cjsatuforc/ScannerRobo/README.md

# Project ScannerLaser

Developing a small laser scanner with a single CMD camera and two lasers. 
One of these lasers is coupled with a small DC motor and the controller of the motor is being implemented in a small arduino nano pro board.

Everything communicating with a PC via USB serial
