cjsatuforc/ScannerRobo/caixa_scanner_otimizada/Caixa_Scanner.SLDASM

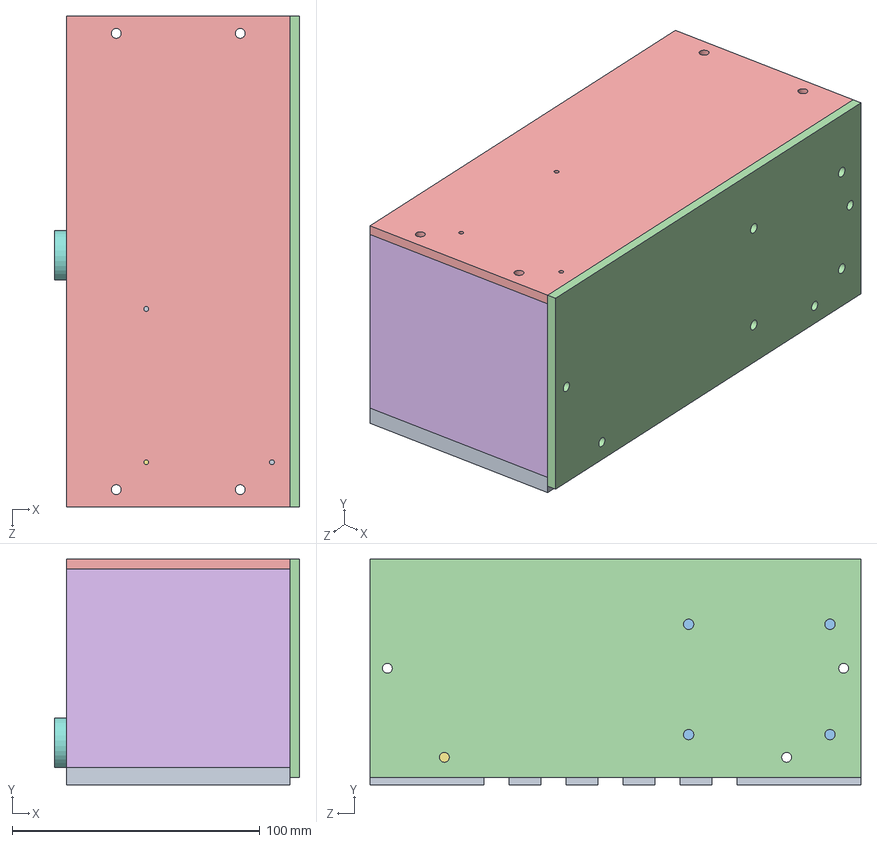
[picture p1: CAD file, 2016-11-16]
caixa_scanner_otimizada/Caixa_Scanner.SLDASM
99.0 x 91.0 x 198.0 mm
Lateral_Fixacao
Placa
Camera
Tampa_Superior
Tampa_Frontal
Tampa_Lateral x 2
Laser_Motor
Laser_Fixo
Bracadeira_Laser
