cjsatuforc/ScannerRobo/caixa_scanner_otimizada/Tampa_Lateral_furada.SLDPRT

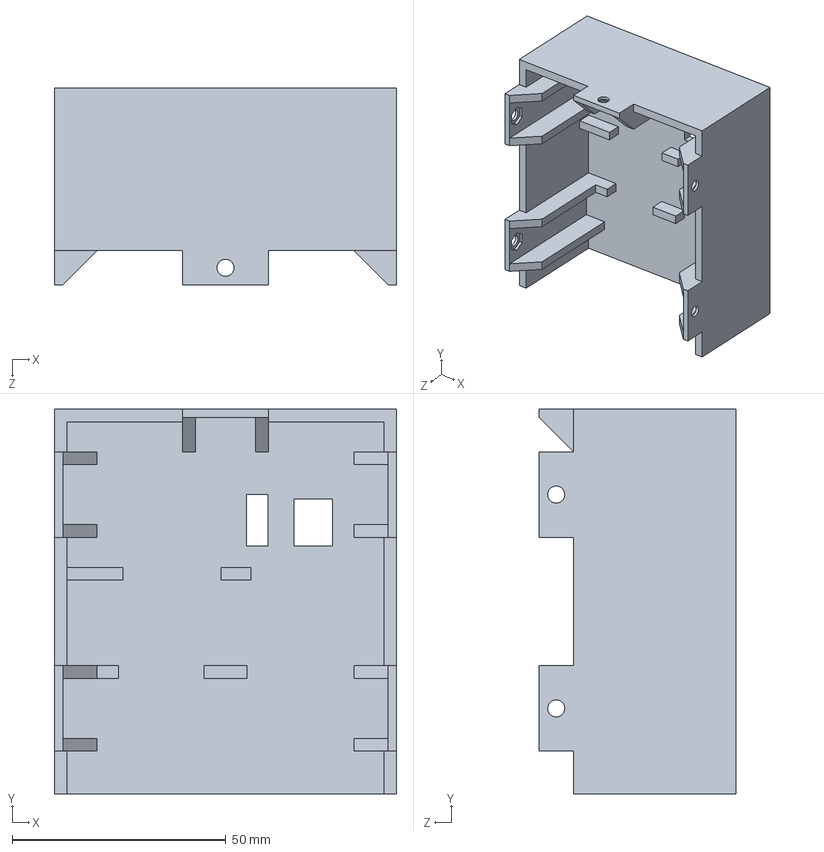
[picture p2: CAD file, 2016-12-11]
caixa_scanner_otimizada/Tampa_Lateral_furada.SLDPRT
80.0 x 90.0 x 46.0 mm
