cjsatuforc/ScannerRobo/caixa_scanner_otimizada/Laser_Motor.SLDPRT

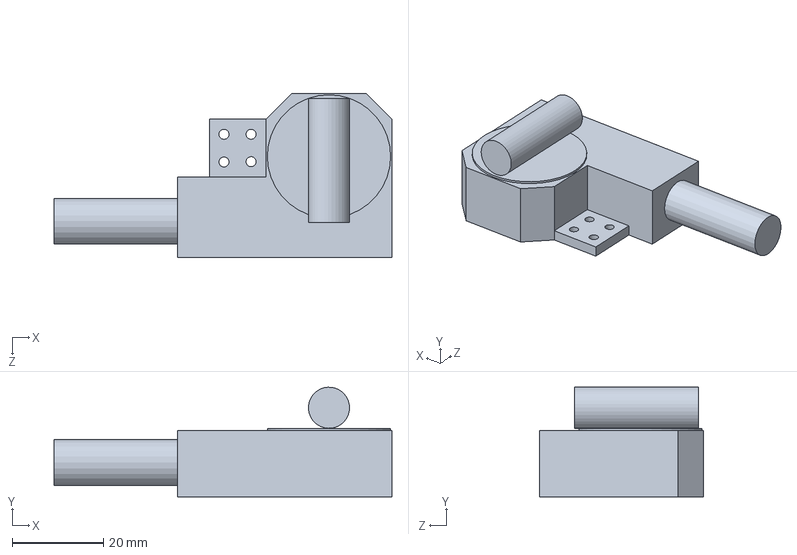
[picture p3: CAD file, 2016-11-16]
caixa_scanner_otimizada/Laser_Motor.SLDPRT
74.0 x 24.0 x 36.0 mm
