cjsatuforc/ScannerRobo/caixa_scanner_otimizada/Tampa_Lateral.SLDPRT

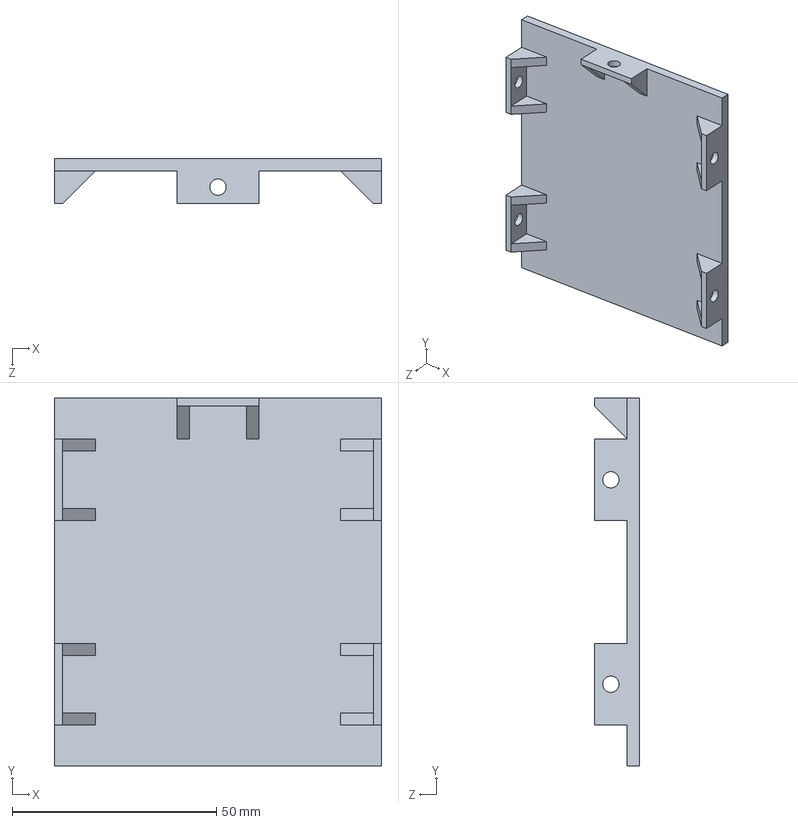
[picture p4: CAD file, 2016-11-16]
caixa_scanner_otimizada/Tampa_Lateral.SLDPRT
80.0 x 90.0 x 11.0 mm
