cjsatuforc/ScannerRobo/caixa_scanner_otimizada/Tampa_Frontal.SLDPRT

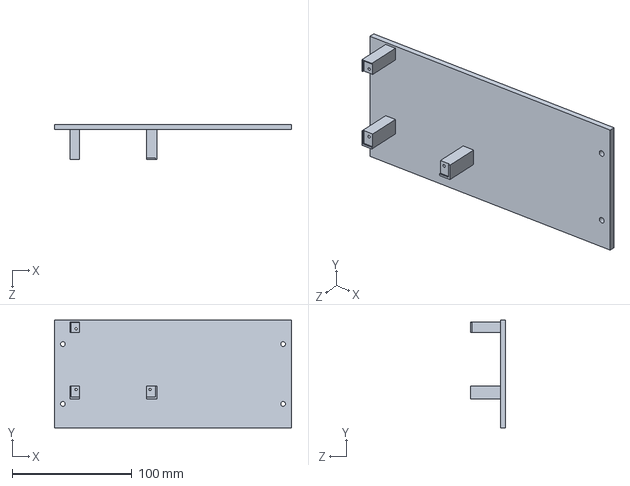
[picture p5: CAD file, 2016-11-16]
caixa_scanner_otimizada/Tampa_Frontal.SLDPRT
198.0 x 90.0 x 29.0 mm
