cjsatuforc/ScannerRobo/caixa_scanner_otimizada/Placa.SLDPRT

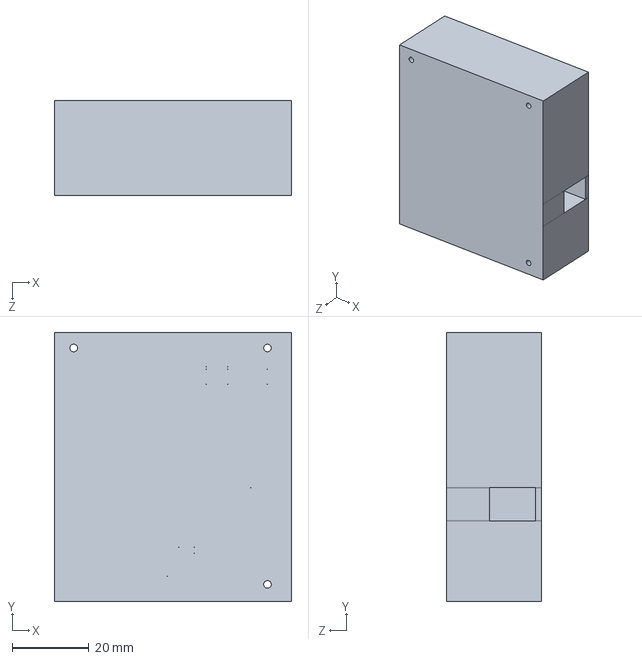
[picture p6: CAD file, 2016-11-16]
caixa_scanner_otimizada/Placa.SLDPRT
62.0 x 70.3 x 25.0 mm
