cjsatuforc/ScannerRobo/caixa_scanner_otimizada/Camera.SLDPRT

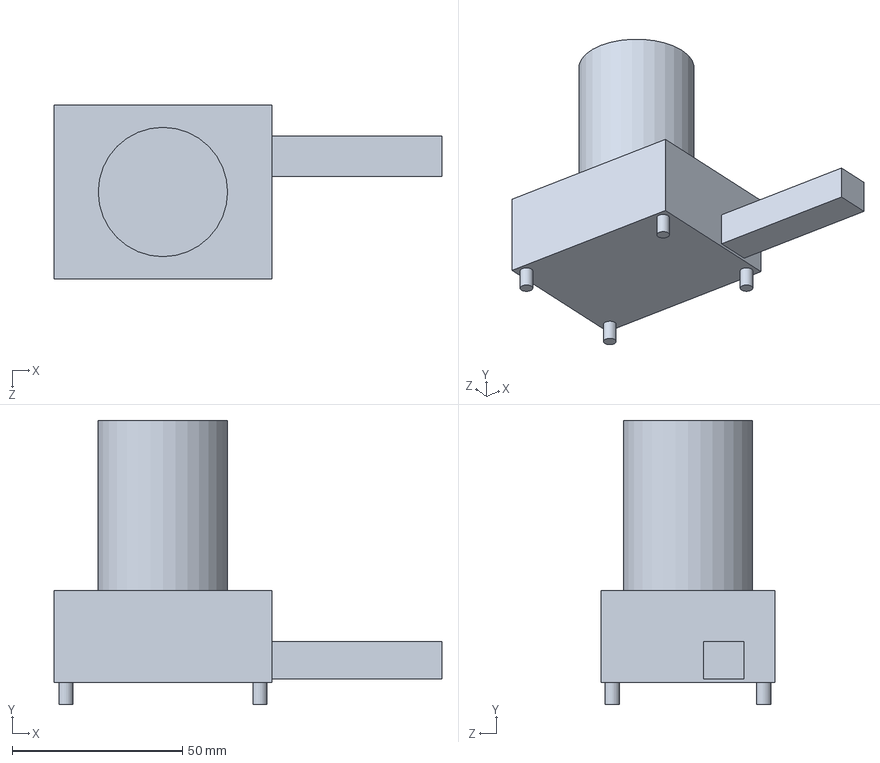
[picture p7: CAD file, 2016-11-16]
caixa_scanner_otimizada/Camera.SLDPRT
114.0 x 83.5 x 51.0 mm
