cjsatuforc/ScannerRobo/caixa_scanner_otimizada/Superficie1.SLDPRT

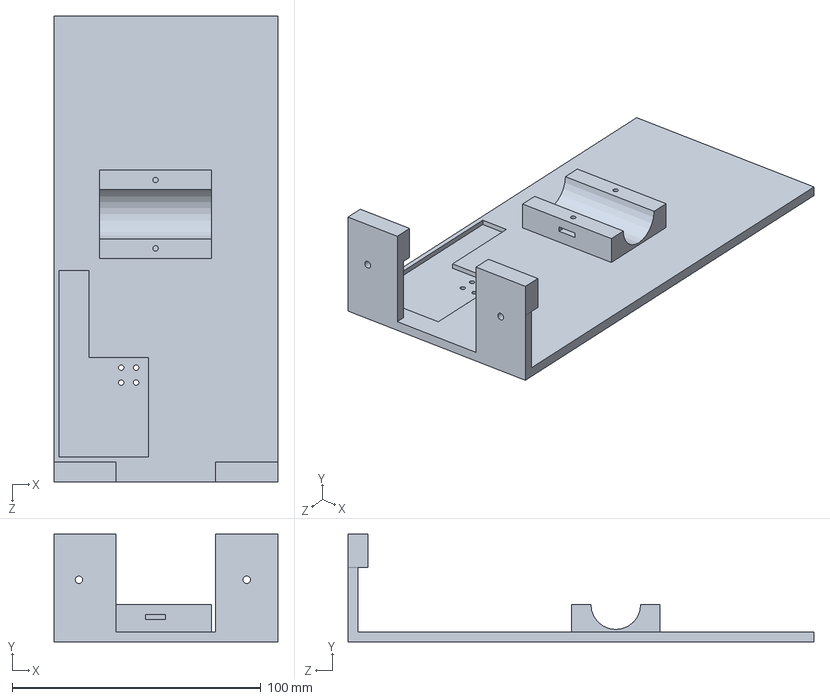
[picture p8: CAD file, 2016-11-16]
caixa_scanner_otimizada/Superficie1.SLDPRT
90.1 x 43.4 x 187.5 mm
