cjsatuforc/ScannerRobo/caixa_scanner_otimizada/Lateral_Fixacao.SLDPRT

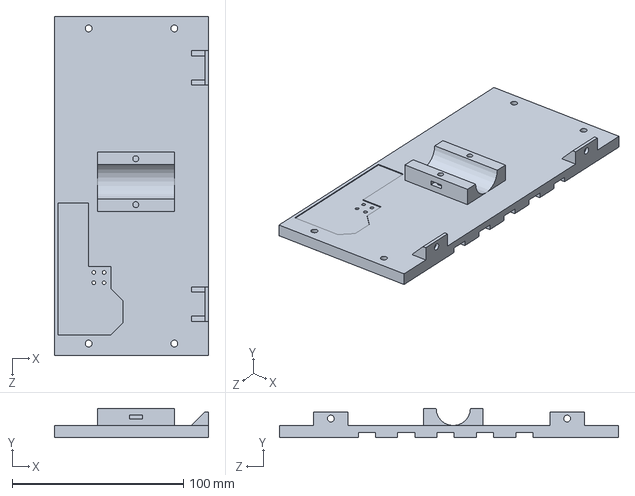
[picture p9: CAD file, 2016-11-16]
caixa_scanner_otimizada/Lateral_Fixacao.SLDPRT
90.0 x 17.0 x 198.0 mm
