cjsatuforc/ScannerRobo/caixa_scanner_otimizada/Laser_Fixo.SLDPRT

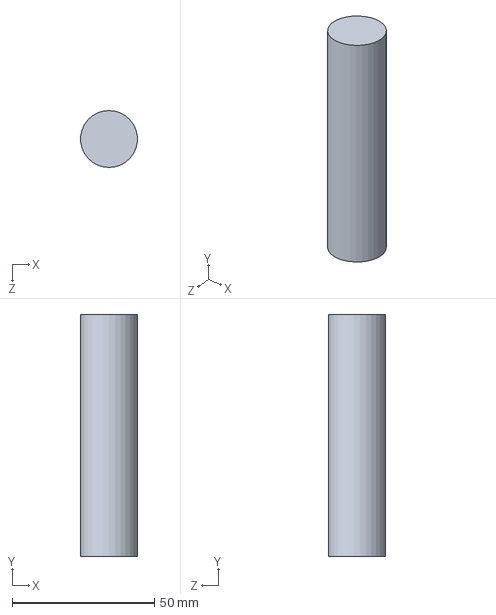
[picture p10: CAD file, 2016-11-16]
caixa_scanner_otimizada/Laser_Fixo.SLDPRT
19.9 x 85.0 x 20.0 mm
