cjsatuforc/ScannerRobo/caixa_scanner_otimizada/Bracadeira_Laser.SLDPRT

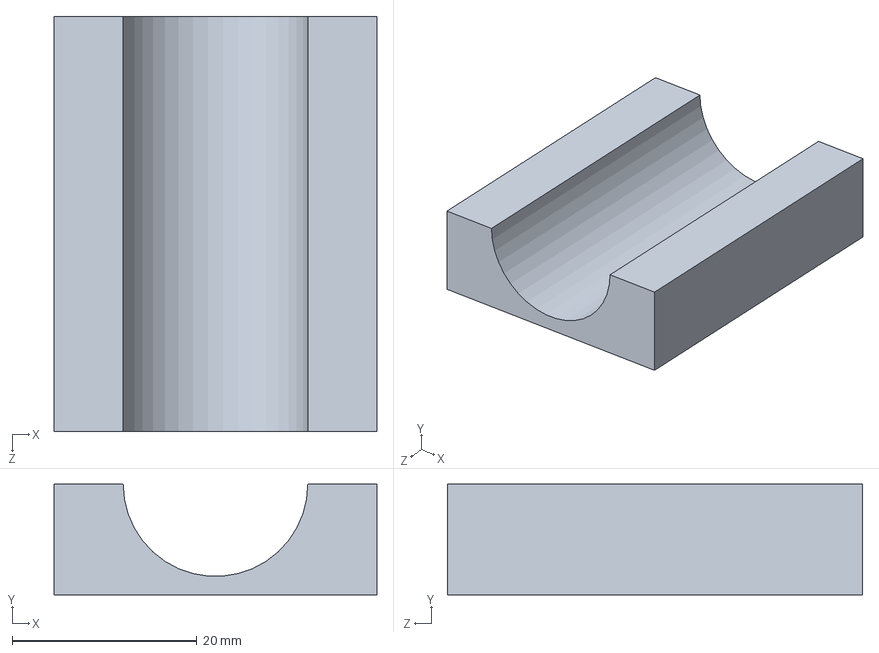
[picture p11: CAD file, 2016-11-16]
caixa_scanner_otimizada/Bracadeira_Laser.SLDPRT
35.0 x 12.0 x 45.0 mm
