cjsatuforc/ScannerRobo/caixa_scanner_otimizada/Tampa_Superior.SLDPRT

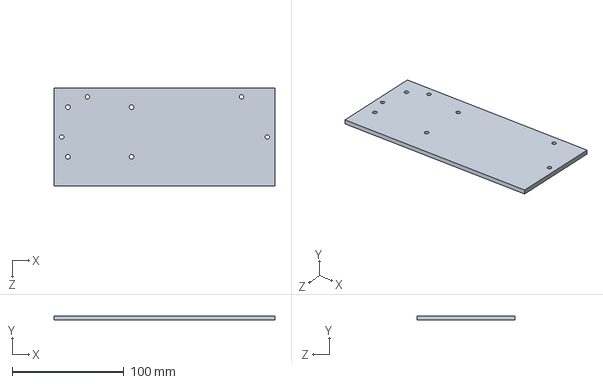
[picture p12: CAD file, 2016-11-16]
caixa_scanner_otimizada/Tampa_Superior.SLDPRT
198.0 x 4.00 x 88.0 mm
