cjsatuforc/ScannerRobo/(list of files, cad)

Other CAD files:
caixa_scanner_otimizada/Lateral_Fixacao.STL
caixa_scanner_otimizada/Tampa_Frontal.STL
caixa_scanner_otimizada/Tampa_Lateral.STL
caixa_scanner_otimizada/Tampa_Lateral_furada.STL
caixa_scanner_otimizada/Tampa_Superior.STL
