cjsatuforc/ScannerRobo/PCBdev/Arduino Micro - Scanner/micro_board.pdf

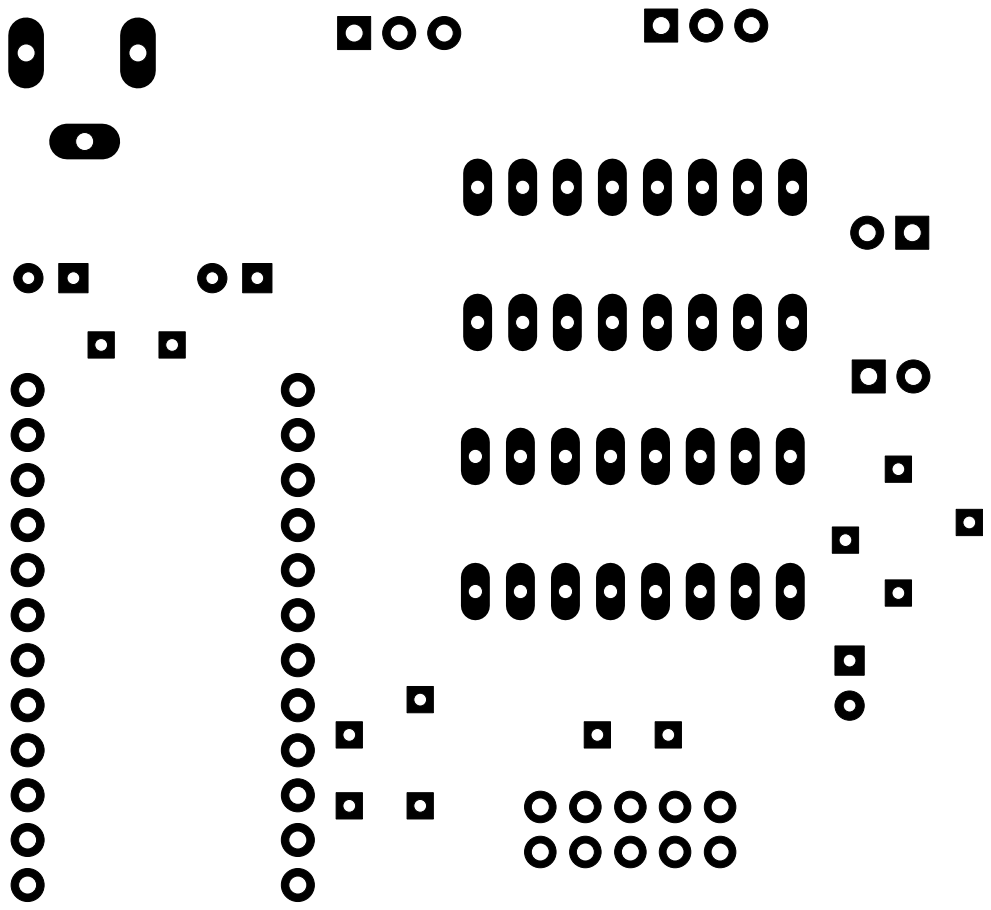
[picture p13: page 1]
