cjsatuforc/ScannerRobo/PCBdev/Arduino Nano - Scanner/nano_board.pdf

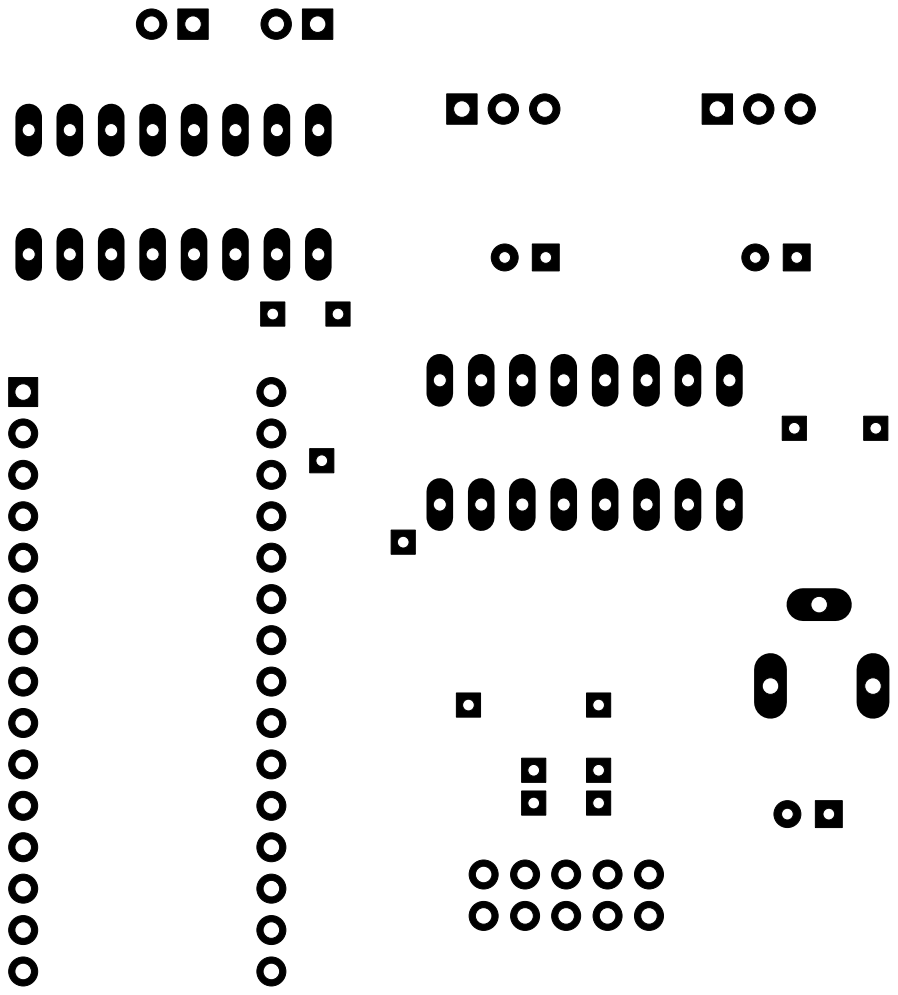
[picture p14: page 1]
