cjsatuforc/ScannerRobo/PCBdev/Arduino Nano - Scanner/micro_board.brd

## EAGLE design PCBdev/Arduino Nano - Scanner/micro_board.brd (2016-11-04)

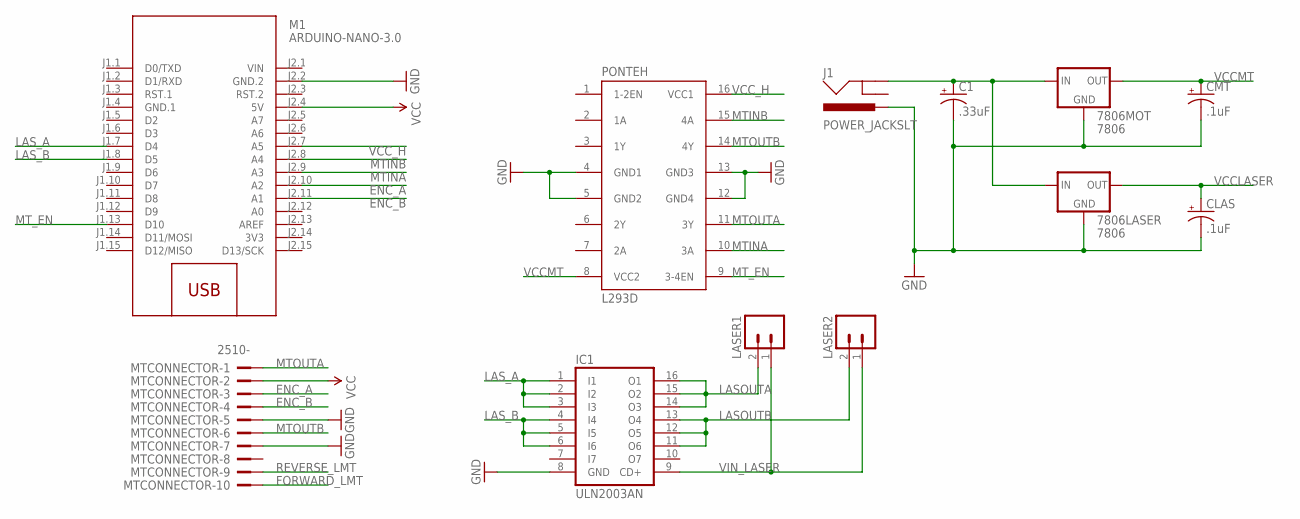
[picture p15: schematic micro_board.sch]

Parts:
7806LASER, 7806MOT: 7806; TO220-IGO
C1: .33uF; CPOL-RADIAL-100UF-25V
CLAS: .1uF; CPOL-RADIAL-100UF-25V
CMT: .1uF; CPOL-RADIAL-100UF-25V
IC1: ULN2003AN; DIL16
J1: POWER_JACKSLT; POWER_JACK_SLOT
LASER1, LASER2: M02POLAR; MOLEX-1X2
M1: ARDUINO-NANO-3.0
MTCONNECTOR: 2510-; PAK100/2500-10
PONTEH: L293D; DIL16

Connections:
3V3: M1.J2.14 (3V3)
ENC_A: M1.J2.10 (A2), MTCONNECTOR.3
ENC_B: M1.J2.11 (A1), MTCONNECTOR.4
FORWARD_LMT: MTCONNECTOR.10
GND: 7806LASER.GND, 7806MOT.GND, C1.2 (-), CLAS.2 (-), CMT.2 (-), IC1.8 (GND), J1.PWR, M1.J2.2 (GND.2), MTCONNECTOR.5, MTCONNECTOR.7, PONTEH.4 (GND1), PONTEH.5 (GND2), PONTEH.12 (GND4), PONTEH.13 (GND3)
GND.1: M1.J1.4 (GND.1)
LASOUTA: IC1.14 (O3), IC1.15 (O2), IC1.16 (O1), LASER1.2
LASOUTB: IC1.11 (O6), IC1.12 (O5), IC1.13 (O4), LASER2.2
LAS_A: IC1.1 (I1), IC1.2 (I2), IC1.3 (I3), M1.J1.7 (D4)
LAS_B: IC1.4 (I4), IC1.5 (I5), IC1.6 (I6), M1.J1.8 (D5)
MTINA: M1.J2.9 (A3), PONTEH.10 (3A)
MTINB: M1.J2.8 (A4), PONTEH.15 (4A)
MTOUTA: MTCONNECTOR.1, PONTEH.11 (3Y)
MTOUTB: MTCONNECTOR.6, PONTEH.14 (4Y)
MT_EN: M1.J1.13 (D10), PONTEH.9 (3-4EN)
REVERSE_LMT: MTCONNECTOR.9
SRCIN: 7806LASER.IN, 7806MOT.IN, C1.1 (+), J1.GND@2 (GND)
VCC: M1.J2.4 (5V), MTCONNECTOR.2
VCCLASER: 7806LASER.OUT, CLAS.1 (+)
VCCMT: 7806MOT.OUT, CMT.1 (+), PONTEH.8 (VCC2)
VCC_H: M1.J2.7 (A5), PONTEH.16 (VCC1)
VIN: M1.J2.1 (VIN)
VIN_LASER: IC1.9 (CD+), LASER1.1, LASER2.1

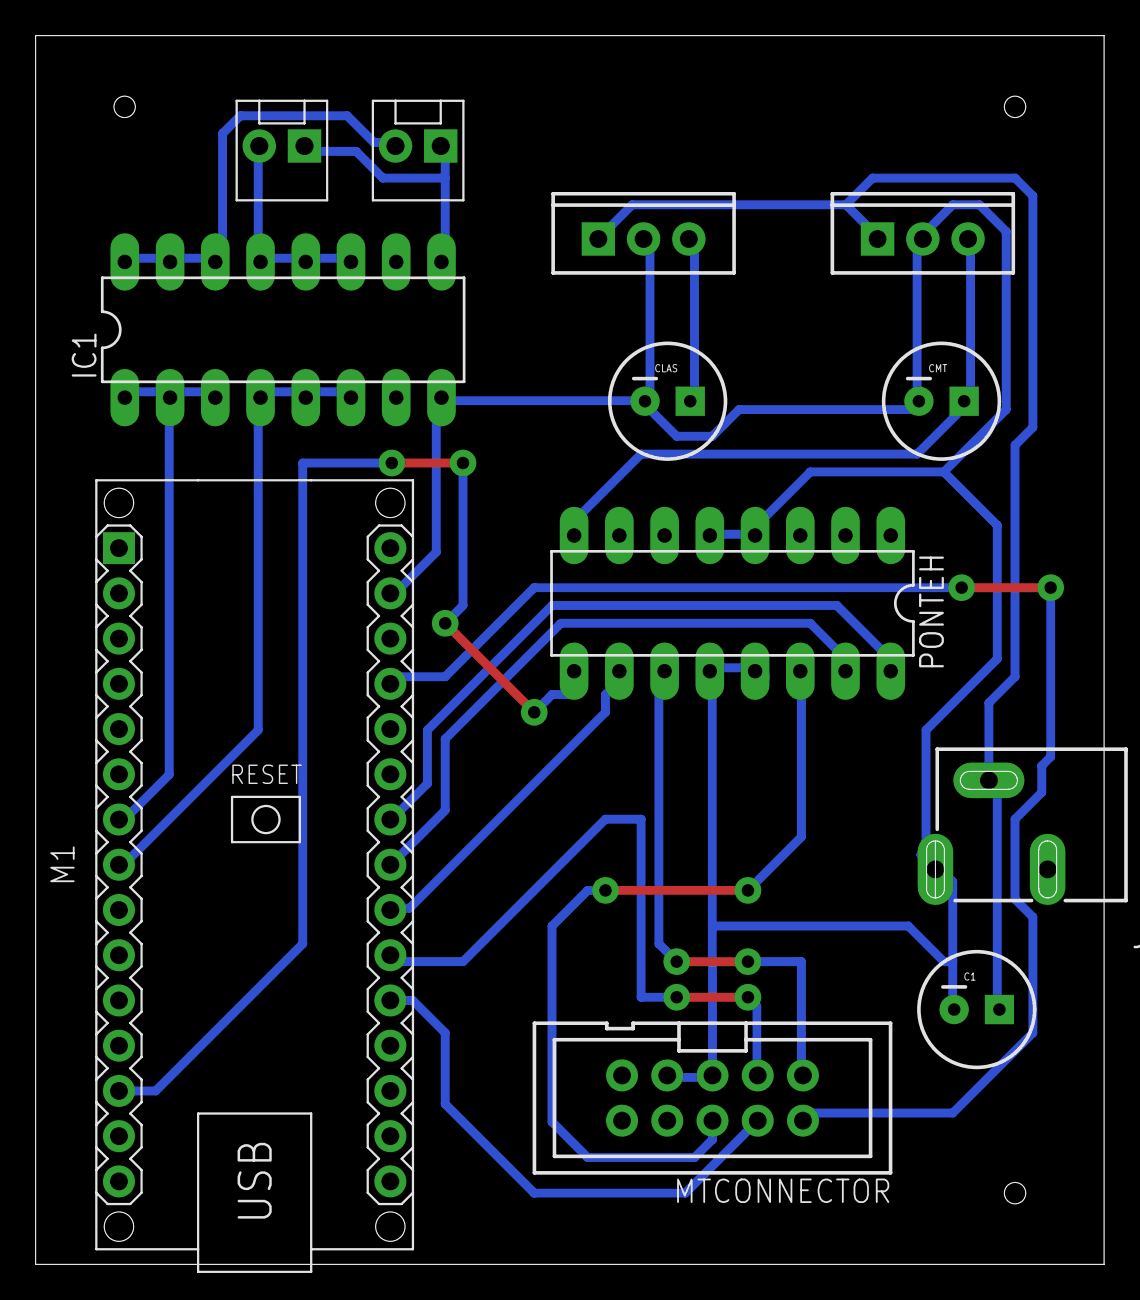
[picture p16: board micro_board.brd from above]

Board: 2 copper layers, 60.0 x 69.0 mm, 12 parts (0 on the bottom side), 18 nets.
