cjsatuforc/ScannerRobo/(commit log)

2016-11-04 Adicionando o PCB e codigos funcionando
    [micro_board.brd, micro_board.sch]
2016-11-16 Adding a 3D model of the box for the sensor
    Solid Works model of the box
    [Bracadeira_Laser.SLDPRT, Caixa_Scanner.SLDASM, Camera.SLDPRT, Laser_Fixo.SLDPRT, Laser_Motor.SLDPRT, Lateral_Fixacao.SLDPRT, Lateral_Fixacao.STL, Placa.SLDPRT]
2016-11-16 Changing folder location of the box model
    [Bracadeira_Laser.SLDPRT, Caixa_Scanner.SLDASM, Camera.SLDPRT, Laser_Fixo.SLDPRT, Laser_Motor.SLDPRT, Lateral_Fixacao.SLDPRT, Lateral_Fixacao.STL, Placa.SLDPRT]
2016-11-25 Alterando o codigo do arduino para executar uma velocidade de PWM default.
2016-11-28 Add tampa lateral furada com furo
    Ainda deve possuir um furo para as porcas.
    [Tampa_Lateral_furada.SLDPRT, Tampa_Lateral_furada.STL]
2016-12-10 Removing unused files
    [micro_board.dxf]
2016-12-10 Adding a fast command to motors
2016-12-11 Tampa Lateral Furada para o HUB
    [Tampa_Lateral_furada.SLDPRT, Tampa_Lateral_furada.STL]
2016-12-11 Adding tampas com HUB
    [Tampa_Lateral_furada.SLDPRT, Tampa_Lateral_furada.STL]
